homonto/ESPnow-MQTT-HomeAssistant-Gateway/receiver/changelog.txt

TODO:
1 - implement #ifdef DEBUG instead of if (debug_mode)
2 - data structure for sensors - change from char[] to digits

2022-07-26:
  1.12.0  - change of the data structure 

2022-07-24:
  1.11.b2 - device name with or without MAC (chose in mqtt_publish_sensors_config())
          - model = ESP32

2022-07-09:
  1.11.b1 - added:
            char sender_type[10]; // "motion" "env"
            char motion[2];       // "0" "1"  [2]
            for motion devices to reuse gateway with the same message structure

2022-07-09:
  1.10.1 - corrections
  1.10.0 - remove MOTION sensor because of interference with antenna

2022-07-09:
  1.9.3  - cleaning (Serial.println(), config.h etc.)
  1.9.2  - motion with interrupts
         - keep motion "Detected" for entire motion_delay_s time since the last detection (not the first detection)
         - few cosmetics

2022-07-08:
  1.9.1  - motion sensor added working always on Gateway

2022-07-04:
  1.9.b1 - battery change rate, redo myData structure

2022-07-04:
  1.8.2 - version and uptime added to GW status

2022-07-02:
  1.8.1 - 3 LEDs, POWER_ON_LED_GPIO_GREEN with PWM

2022-07-02:
  1.8.0 - common script for multiple receivers (DEVICE_ID and config.h)

2022-06-29:
  1.7.2 - added support for ESP32-S3 board
        - 2x LED: 1 for gateway device (STATUS_GW_LED_GPIO_RED) and 1 for sensor device (SENSORS_LED_GPIO_BLUE)

2022-06-26:
  1.7.1 - change name of the device on HA (all devices) to: ESPnow_hostname_name

2022-06-26:
  1.7.0 - incoming messages in the queue to avoid losing data

2022-06-24:
  1.6.2 - #define GND_GPIO_FOR_LED      13    // if not equipped comment out - GND for ACTIVITY_LED_GPIO
        - testing esp_wifi_set_protocol(WIFI_IF_STA, WIFI_PROTOCOL_11B|WIFI_PROTOCOL_11G|WIFI_PROTOCOL_11N|WIFI_PROTOCOL_LR);
          to extend the range of radio (no conclusion yet)
2022-06-22:
  1.6.1 - pretty_ontime implemented as string

2022-06-22:
  1.6.0 - ontime implemented in seconds

2022-06-21:
  1.5.0 - gateway firmware update implemented

2022-06-19:
  1.4.1 - cleaning for github

2022-06-18:
  1.4.0 - bootCount added

2022-06-15:
  1.3.0 - switch "publish" to enable/disable publishing to HA
        - buttons: update/restart
        - update FW on gateway not yet implemented

2022-06-11:
  1.2.0 - added device name on sender, myData.name on receiver, it goes to name of the device on HA

2022-06-11:
  1.1.0 - added lux from TEPT/ADC, added CHARGING

2022-06-10:
  1.0.0 - journey started ;-)
