homonto/ESPnow-MQTT-HomeAssistant-Gateway/(list of files, drawings)

Other design files:
sender/pcb/easyeda/ESP32S2-new sensor device template/PCB_7-OK- ORDERED.json
