homonto/ESPnow-MQTT-HomeAssistant-Gateway/sender/passwords.h

/*
example
*/

#define BT_SSID               "ssid"
#define BT_PASSWORD           "password"
//only path - WITHOUT the binary file name i.e. http://my.server.com/espbinary/devicex"
#define UPDATE_FIRMWARE_HOST  "http://ip/path"
