homonto/ESPnow-MQTT-HomeAssistant-Gateway/(commit log)

2022-06-20 Update sender.ino
    Serial.printf instead of print(ln)
2022-06-20 1.8.2-reset bootCount on DRD_Detected
    [sender.ino]
2022-06-22 1.9.0 - ontime saved, define ESP32_IS_CHEATING
2022-06-23 added new device: esp32087 WROVER
2022-06-23 1.10.0 - PPK2_GPIO and ESP32_IS_CHEATING done for ESP32S (325ms)
2022-06-23 1.10.1 - ESP32_IS_CHEATING measured for ESP32-S2
2022-06-24 Lilygo1a LED cathode is not to GND but to GPIO13
2022-06-24 new devices added
2022-06-24 1.10.2 - #define GND_GPIO_FOR_LED + WIFI_PROTOCOL_LR
2022-06-24 1.6.2 - #define GND_GPIO_FOR_LED + WIFI_PROTOCOL_LR
2022-06-24 1.10.3 - print MAC address while connecting to AP
2022-06-26 1.7.0 - incoming messages in the queue to avoid losing data
    [config.h, espnow.h, mqtt.h, mqtt_publish_gw_data.h, mqtt_publish_sensors_data.h, receiver.ino, variables.h]
2022-06-26 1.10.5 - blink FW_UPGRADE_LED_GPIO on FAILED
    [sender.ino]
2022-06-28 1.11.0 - major rework on charging_state()
    [devices_config.h, sender.ino]
2022-06-28 1.11.1 - boot_reason added to reset bootCount on button reset
    [devices_config.h, sender.ino]
2022-06-29 1.7.1 - change name of the device on HA
2022-06-29 1.7.2 - added support for ESP32-S3 board, STATUS_GW_LED_GPIO
2022-06-29 "esp32092" - S3 with LED
2022-07-02 1.8.0 - common script for multiple receivers 1.8.1 - 3 LEDs + PWM
2022-07-04 1.9.b1 - battery change rate, redo myData structure
2022-07-04 1.14.b1 - battery change rate, redo myData structure, fake receiver, lipo.quickStart abandoned
    1.14.b1 - battery change rate, redo myData structure, fake receiver, lipo.quickStart abandoned
2022-07-05 1.14.0 - rename LEDs, blink RED on error, MINIMUM_VOLTS=3.5V
    [devices_config.h, sender.ino]
2022-07-06 1.14.1 - turn off ENABLE_3V_GPIO when gather_data() fails
    [devices_config.h, sender.ino]
2022-07-08 added Easyeda
    [PCB_7-OK- ORDERED.json]
2022-07-08 1.9.1 - motion sensor added working always on Gateway
2022-07-09 1.9.2 - motion interrupts, "Detected" for entire motion_delay_s time
2022-07-09 1.9.3 - cleaning (Serial.println(), config.h etc.)
2022-07-10 1.10.0 - remove MOTION sensor because of interference with antenna
    [config.h, mqtt.h, mqtt_publish_gw_data.h, receiver.ino, variables.h]
2022-07-23 1.15.0-"motion" "env" ok + corrections
    [sender.ino]
2022-07-23 new board added, testing on 100 papa
2022-07-24 1.15.1 - USE_MAX17048 reset on reset button or power reconnect
    [devices_config.h, sender.ino]
2022-07-24 1.15.1a-lipo.reset() on reset button or power reconnect
    [devices_config.h, sender.ino]
2022-07-24 1.11.b2 - model = ESP32
2022-07-24 1.15.2 - MINIMUM_VOLTS=3.3V for new devices
2022-07-26 deploying new devices
2022-07-30 1.16.1 - new devices: 100. 101, 102, 104 - PERIODIC_FW_CHECK_HRS 14400
2022-07-31 1.16.2 - print MAC and IP
